eSpark-Backup/noise-alarm-v4.5-final/_Design Files v4.5/Audio_Meter_V4.5 - NEW.PcbDoc.htm

Reporting Options

# File in Newer Format

Date | : | 10/12/2020
Time | : | 4:24:38 PM
Filename | : | C:\Users\eSpark Group\Desktop\Final Core Files\Noise Alarm v4.5 - Final\_Design Files v4.5\Audio_Meter_V4.5 - NEW.PcbDoc

Version | Warning
Release 20.0 | CAUTION - Support of propagation delay for primitives

This file was generated by a later version of the software
