eSpark-Backup/noise-alarm-v4.5-final/_Deliverable/BOM/EDU BOM.xlsx

Bill of Material (BOM) for Eduardo_SMPS
S. No. | Comment Type | Description | Designator | Footprint (Package) | Manufacturer Part Number | Manufacturer | Value | Quantity | Total Quantity | Link | Unit Price | Total Price | Remarks
1 | Capacitor | CAP CER 0.1UF 50V Y5V 0805 | C1, C2, C3, C4, C7, C10, C12, C17, C19, C22, C24, C25, C76 | Cap0805 | CL21F104ZBCNNNC | Samsung | 0.1uF | 13 | 650 | Digikey (https://www.digikey.com/en/products/detail/samsung-electro-mechanics/CL21F104ZBCNNNC/3886665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) | $0.01 | $7.93
2 |  | CAP CER 1000PF 760VAC Y5U RADIAL | C5 | RAD-0.4 | 440LD10-R | Vishay | 1000pF | 1 | 50 | Mouser (https://eu.mouser.com/ProductDetail/Vishay-Cera-Mite/440LD10-R) | $0.49 | $24.50
3 |  | CAP CER 1UF 16V X7R 1206 | C8, C9 | Cap1206 | 1206YC105K4T2A | Kyocera AVX | 1uF | 2 | 100 | Digikey (https://www.digikey.com/en/products/detail/avx-corporation/1206YC105K4T2A/3081814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) | $0.15 | $14.85
4 |  | CAP CER 1UF 16V X7R 0805 | C11, C13, C16, C18, C78 | Cap0805 | CL21B105KOFNNNG | Samsung | 1uF | 5 | 250 | Digikey (https://www.digikey.com/en/products/detail/samsung-electro-mechanics/CL21B105KOFNNNG/3894469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) | $0.02 | $6.12
5 |  | CAP CER 4.7UF 16V 10% X5R 0805 | C26 | Cap0805 | C0805C475K4PACTU | KEMET | 4.7UF | 1 | 50 | Digikey (https://www.digikey.com/en/products/detail/kemet/C0805C475K4PACTU/2057920) | $0.11 | $5.47
6 |  | CAP CER 1000PF 200V X7R 0603 | CF1 | Cap0603 | 0603B102K201CT | Walsin Technologies | 1nF | 1 | 50 | Digikey (https://www.digikey.com/en/products/detail/walsin-technology-corporation/0603B102K201CT/9354876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) | $0.04 | $1.87
7 |  | CAP CER 0.33UF 50V X7R 0603 | CF3 | Cap0603 | CGA3E3X7R1H334M080AB | TDK | 0.33uF | 1 | 50 | Digikey (https://www.digikey.com/en/products/detail/tdk-corporation/CGA3E3X7R1H334M080AB/4931466) | $0.12 | $5.88
8 |  | CAP ALUM 560UF 20% 10V SMD | CF4, CF7 | EEE-TC1A561UV | EEE-TC1A561UV | Panasonic | 560uF | 2 | 100 | Digikey (https://www.digikey.com/en/products/detail/panasonic-electronic-components/EEE-TC1A561UV/10290506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) | $0.73 | $72.56
9 |  | CAP ALUM 4.7UF 20% 400V SMD | CF10, CF11 | ULR2G4R7MNL1GS | ULR2G4R7MNL1GS | Nichicon | 4.7uF | 2 | 100 | Digikey (https://www.digikey.com/en/products/detail/nichicon/ULR2G4R7MNL1GS/3664129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) | $0.39 | $39.03
10 | Diode | TVS DIODE 70.1V 113V DO214AA | D1 | SMB | SMBJP6KE82A-TP | MCC | SMBJP6KE82A-TP | 1 | 50 | Digikey (https://www.digikey.com/en/products/detail/micro-commercial-co/SMBJP6KE82A-TP/2345614) | $0.28 | $14.00
11 |  | DIODE GEN PURP 600V 1A SMB | D2 | SMB | MURS160-13 | Diodes | MURS160-13 | 1 | 50 | Digikey (https://www.digikey.com/en/products/detail/MURS160-13-F/MURS160-FDICT-ND/815906?curr=usd) | $0.28 | $14.10
12 |  | Diode Switching 100V 1A 2Pin SMA | D3 | SMA | RS1B-13-F | Diodes | RS1B-13-F | 1 | 50 | Digikey (https://www.digikey.com/en/products/detail/diodes-incorporated/RS1B-13-F/717796) | $0.28 | $14.15
13 |  | DIODE SCHOTTKY 30V 1A SOD123W | D4 | PMEG3010ER,115 | PMEG3010ER,115 | NXP Semiconductors | PMEG3010ER,115 | 1 | 50 | Digikey (https://www.digikey.com/en/products/detail/nexperia-usa-inc/PMEG3010ER115/2119868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) | $0.27 | $13.60
14 |  | DIODE SCHOTTKY 40V 3A SMB | DF1 | SMB | B340LB-13-F | Diodes | B340LB-13-F | 1 | 50 | Digikey (https://www.digikey.com/en/products/detail/diodes-incorporated/B340LB-13-F/755461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) | $0.32 | $15.90
15 |  | RECT BRIDGE GPP 1A 400V DFS | DF4 | DF04S-T | DF04S-T | Diodes | DF04S-T | 1 | 50 | Digikey (https://www.digikey.com/en/products/detail/diodes-incorporated/DF04S-T/1934941) | $0.37 | $18.45
16 | LED | ADDRESS LED DISC SERIAL RGB 1=10 | LED2 | 1655 | 1655 | Adafruit Industries | 1655 | 1 | 50 | Digikey (https://www.digikey.com/en/products/detail/adafruit-industries-llc/1655/5154679) | $4.50 | $225.00
17 | Inductor | Ind Power Wirewound 470uH 10% 140mA 1812 | L1 | 84474C | 84474C | Murata | 470uH | 1 | 50 | Digikey (https://www.digikey.com/en/products/detail/murata-power-solutions-inc/84474C/5798743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) | $0.37 | $18.70
18 | Mosfet | MOSFET P-CHAN 24V SOT23 | Q1 | SOT-23 | DMP2045U-7 | Diodes | DMP2045U-7 | 1 | 50 | Digikey (https://www.digikey.com/en/products/detail/diodes-incorporated/DMP2045U-7/8275356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) | $0.28 | $14.14
19 |  | TRANS NPN 40V 0.6A SMD SOT23-3 | Q2, Q3 | SOT-23 | MMBT2222A-7-F | Diodes | MMBT2222A-7-F | 2 | 100 | Digikey (https://www.digikey.com/en/products/detail/diodes-incorporated/MMBT2222A-7-F/814503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) | $0.05 | $5.00
20 |  | MOSFET N-CH 50V 200MA SOT-23 | Q4 | SOT-23 | BSS138LT1G | ON Semiconductor | BSS138LT1G | 1 | 50 | Digikey (https://www.digikey.com/en/products/detail/on-semiconductor/BSS138LT1G/918376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) | $0.17 | $8.60
21 |  | MOSFET N-CH 600V 2A DPAK | QS1 | STD2HNK60Z | STD2HNK60Z | STMicroelectronics | STD2HNK60Z | 1 | 50 | Digikey (https://www.digikey.com/en/products/detail/stmicroelectronics/STD2HNK60Z/1653989) | $0.83 | $41.72
22 | Resistor | RES SMD 1K OHM 5% 1/2W 0805 | R1, R6 | RES0805 | ERJ-P06J102V | Panasonic | 1K | 2 | 100 | Digikey (https://www.digikey.com/en/products/detail/panasonic-electronic-components/ERJ-P06J102V/525197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) | $0.04 | $3.60
23 |  | RES SMD 10K OHM 5% 1/2W 0805 | R2, R3, R4, R5, R8, R10, R12, R14, R24, R29, R39, R43, R56, R57, RC2, RC3 | RES0805 | ERJ-P06J103V | Panasonic | 10K | 16 | 800 | Digikey (https://www.digikey.com/en/products/detail/panasonic-electronic-components/ERJ-P06J103V/525198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) | $0.04 | $28.80
24 |  | RES SMD 47K OHM 1% 1/3W 0805 | R7 | RES0805 | CRCW080547K0FKEAHP | Vishay | 47K | 1 | 50 | Digikey (https://www.digikey.com/en/products/detail/vishay-dale/CRCW080547K0FKEAHP/2222360) | $0.19 | $9.65
25 |  | RES SMD 100K OHM 5% 1/2W 0805 | R9, R26 | RES0805 | ERJ-P06J104V | Panasonic | 100K | 2 | 100 | Digikey (https://www.digikey.com/en/products/detail/panasonic-electronic-components/ERJ-P06J104V/525199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) | $0.04 | $3.60
26 |  | RES SMD 220K OHM 5% 1/2W 0805 | R11 | RES0805 | ERJ-P06J224V | Panasonic | 220K | 1 | 50 | Digikey (https://www.digikey.com/en/products/detail/panasonic-electronic-components/ERJ-P06J224V/525240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) | $0.09 | $4.70
27 |  | RES SMD 470K OHM 1% 1/3W 0805 | R13 | RES0805 | CRCW0805470KFKEAHP | Vishay Dale | 470K | 1 | 50 | Digikey (https://www.digikey.com/en/products/detail/vishay-dale/CRCW0805470KFKEAHP/2227258) | $0.19 | $9.65
28 |  | RES SMD 665 OHM 1% 1/16W 0402 | R28 | Res0402 | RC0402FR-07665RL | Yageo | 665R | 1 | 50 | Digikey (https://www.digikey.com/en/products/detail/yageo/RC0402FR-07665RL/5281068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) | $0.01 | $0.70
29 |  | RES SMD 1M OHM 5% 1/2W 0805 | R32, R33 | RES0805 | ERJ-P06J105V | Panasonic | 1M | 2 | 100 | Digikey (https://www.digikey.com/en/products/detail/panasonic-electronic-components/ERJ-P06J105V/525200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) | $0.04 | $3.60
30 |  | RES SMD 10K OHM 5% 1/16W 0402, RES SMD 10K OHM 1% 1/10W 0402 | RC1, RF11, RF17 | Res0402 | RC0402JR-0710KL, ERJ-2RKF1002X | Yageo, Panasonic | 10K | 3 | 150 | Digikey (https://www.digikey.com/en/products/detail/yageo/RC0402JR-0710KL/726418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) | $0.10 | $15.00 | Review remaining
31 |  | RES 5.11M OHM 1% 1/4W 0805 | RF2, RF6, RF7 | RES 0805 | RK73H2ATTD5114F | KOA Speer | 5.11M | 3 | 150 | Digikey (https://www.digikey.com/en/products/detail/koa-speer-electronics-inc/RK73H2ATTD5114F/10234574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) | $0.01 | $1.86
32 |  | RES 487 OHM 1% 1/10W 0402 | RF8 | Res0402 | RK73H1ETTP4870F | KOA Speer | 487R | 1 | 50 | Digikey (https://www.digikey.com/en/products/detail/koa-speer-electronics-inc/RK73H1ETTP4870F/9844141) | $0.02 | $1.10
33 |  | RES 10 OHM 5% 1/10W 0402 | RF10 | Res0402 | RK73B1ETTP100J | KOA Speer | 10R | 1 | 50 | Digikey (https://www.digikey.com/en/products/detail/koa-speer-electronics-inc/RK73B1ETTP100J/9843968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) | $0.01 | $0.75
34 |  | RES SMD 10 OHM 5% 3W 2512 | RF12 | RES 2512 | 352210RJT | TE Connectivity CGS | 10R | 1 | 50 | Digikey (https://www.digikey.com/en/products/detail/te-connectivity-passive-product/352210RJT/5244975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) | $0.47 | $23.45
35 |  | RES 4.64K OHM 1% 1/10W 0402 | RF13 | Res-0402 | RK73H1ETTP4641F | KOA Speer | 4.64K | 1 | 50 | Digikey (https://www.digikey.com/en/products/detail/koa-speer-electronics-inc/RK73H1ETTP4641F/9844303) | $0.02 | $1.10 | Part changed. Need to change in design
36 |  | RES SMD 2.05 OHM 1% 1/10W 0603 | RF14 | Res0603 | CRCW06032R05FKEA | Vishay Dale | 2.05R | 1 | 50 | Digikey (https://www.digikey.com/en/products/detail/vishay-dale/CRCW06032R05FKEA/1961570) | $0.04 | $1.90 | Part changed. Need to change in design
37 |  | RES SMD 121K OHM 1% 1/10W 0402 | RF15 | Res0402 | ERJ-2RKF1213X | Panasonic | 121K | 1 | 50 | Digikey (https://www.digikey.com/en/products/detail/panasonic-electronic-components/ERJ-2RKF1213X/192111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) | $0.02 | $1.10
38 |  | RES 30.1K OHM 1% 1/10W 0402 | RF16 | Res0402 | RK73H1ETTP3012F | KOA Speer | 30.1K | 1 | 50 | Digikey (https://www.digikey.com/en/products/detail/koa-speer-electronics-inc/RK73H1ETTP3012F/9844092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) | $0.02 | $1.10
39 |  | RES SMD 22.6 OHM 1% 1/10W 0402 | RF18 | Res0402 | ERJ-2RKF22R6X | Panasonic | 22.6R | 1 | 50 | Digikey (https://www.digikey.com/en/products/detail/panasonic-electronic-components/ERJ-2RKF22R6X/79731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) | $0.02 | $1.10
40 |  | RES SMD 3.01K OHM 1% 1/10W 0402 | RF19 | Res-0402 | ERJ-2RKF3011X | Panasonic | 3.01K | 1 | 50 | Digikey (https://www.digikey.com/en/products/detail/panasonic-electronic-components/ERJ-2RKF3011X/192277) | $0.02 | $1.10 | Part changed. Need to change in design
41 | Switch | Tactile Switch SPST-NO Side Actuated Surface Mount, Right Angle | SW2 | KSS221GLFS | KSS221GLFS | ITT C&K | Switch | 1 | 50 | Digikey (https://www.digikey.com/product-detail/en/c-k/KSS221GLFS/401-1097-1-ND/417665) | $0.56 | $28.10
42 | Transformer | FLYBACK XFRM WE-FB T-WIN | TR1 | 750312723 | 750312723 | Wurth Electronics Midcom | 750312723 | 1 | 50 | Digikey (https://www.digikey.com/en/products/detail/w%C3%BCrth-elektronik/750311558/3992650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) | $5.75 | $287.45
43 | IC | SPU-TOP MIC IOT FOCUSED MIC | U1 | SPU0410HR5H-PB | SPU0410HR5H-PB | Knowles | SPU0410HR5H-PB | 1 | 50 | Digikey (https://www.digikey.com/product-detail/en/knowles/SPU0410HR5H-PB/423-1138-1-ND/2420982) | $0.70 | $35.19
44 |  | IC OPAMP GP 1 CIRCUIT SOT23-5 | U2, U3 | SOT23-5 | OPA344NA/250 | Texas Instruments | OPA344NA/250 | 2 | 100 | Digikey (https://www.digikey.com/product-detail/en/texas-instruments/OPA344NA-250/OPA344NACT-ND/362263) | $1.05 | $104.80
45 |  | IC SWITCH QUAD SPST 16TSSOP | U4 | 16-TSSOP | ADG712BRUZ-REEL | Analog Devices | ADG712BRUZ-REEL | 1 | 50 | Digikey (https://www.digikey.com/product-detail/en/analog-devices-inc/ADG712BRUZ-REEL/ADG712BRUZ-REELCT-ND/3771193) | $2.39 | $119.26
46 |  | WIFI MODULE 128MBITS SPI FLASH | U5 | ESP32-WROOM-32 (16MB) | ESP32-WROOM-32 (16MB) | Espressif Systems | ESP32-WROOM-32 (16MB) | 1 | 50 | Digikey (https://www.digikey.com/product-detail/en/espressif-systems/ESP32-WROOM-32D-16MB/1904-1025-1-ND/9381734) | $4.50 | $225.00
47 |  | IC REG LINEAR 3.3V 1A 8XDFN | U6 | NCP186AMX330TAG | NCP186AMX330TAG | ON Semiconductor | NCP186AMX330TAG | 1 | 50 | Digikey (https://www.digikey.com/product-detail/en/on-semiconductor/NCP186AMX330TAG/NCP186AMX330TAGOSCT-ND/5761671) | $0.35 | $17.30
48 |  | IC BAT CHG LI-ION 1 CELL SOT23-6 | U7 | SOT-23-6 | BQ21040DBVR | Texas Instruments | BQ21040DBVR | 1 | 50 | Digikey (https://www.digikey.com/product-detail/en/texas-instruments/BQ21040DBVR/296-47315-1-ND/7688325) | $1.01 | $50.40
49 |  | SENS HUMID/TEMP 3.6V I2C 2% 6DFN | U10 | SI7021-A20-GM1R | SI7021-A20-GM1R | Silicon Labs | SI7021-A20-GM1R | 1 | 50 | Digikey (https://www.digikey.com/en/products/detail/silicon-labs/SI7021-A20-GM1R/5048935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) | $3.24 | $162.18
50 |  | IC REG CTRLR FLYBK ISO SOT23-6 | IC2 | SOT-23-6 | UCC28700DBVR | Texas Instruments | UCC28700DBVR | 1 | 50 | Digikey (https://www.digikey.com/en/products/detail/texas-instruments/UCC28700DBVR/3588896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) | $0.98 | $49.00
51 | Connector | CABLE ADAPTER 6 POS | J1 | TC2030-IDC | TC2030-IDC | Tag-Connect | TC2030-IDC | 1 | 3 | Digikey (https://www.digikey.com/en/products/detail/tag-connect-llc/TC2030-IDC/4571121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) | $42.44 | $127.32
52 |  | CONN HEADER VERT 2POS 2.5MM | J5 | B2B-EH-A(LF)(SN) | B2B-EH-A(LF)(SN) | JST | B2B-EH-A(LF)(SN) | 1 | 50 | Digikey (https://www.digikey.com/products/en?keywords=B2B-EH-A(LF)(SN)) | $0.08 | $4.19
53 |  | TERMINAL BLOCK 2POS 5.08MM SIDE | J6, J7 | Terminal Block 2P | Terminal Block 2POS | TE Connectivity | Terminal Block 2POS | 2 | 100 | Digikey (https://www.digikey.com/product-detail/en/te-connectivity-amp-connectors/1776493-2/A122765-ND/2293915) | $0.49 | $48.62
54 |  | Test Point ON | P2, P4, P5, P6, P7, P8, P9, P18, P19, P20 | TEST POINT | TEST POINT |  | TEST POINT | 10 | 50 |  |  | $0.00 | DO NOT Mount
55 |  | Solder Bridge ON | SB1, SBxx | Solder Bridge | Solder Bridge |  | Solder Bridge | 2 | 10 |  |  | $0.00 | DO NOT Mount
 |  |  |  |  |  |  |  | Total Component Cost |  |  |  | $1954.25
 |  | Notes:
 |  | 1- The costing is done for Fifty (50) boards. All components will be calculated with multiplication factor Fifty (50).
 |  | 2- Supplier costing and custom charges are added in the final cost.
