eSpark-Backup/noise-alarm-v4.5-final/_Design Files v4.5/Audio_Meter_V4.5.step

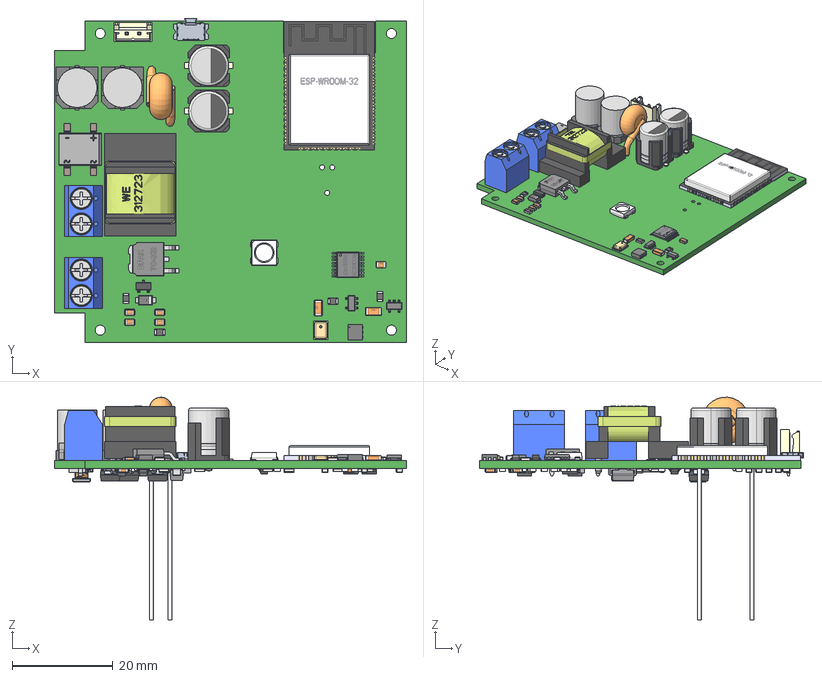
[picture p1: CAD file, 2020-10-13]
_Design Files v4.5/Audio_Meter_V4.5.step
70.0 x 64.5 x 44.3 mm
Board
Extruded
User_Library-RES_1005-0402 x 11
spu0410hr5h-pb
DFN6_3X3
440LD10-R
KSS221GLFS
User_Library-B2B-EH-A
User_Library-Terminal_block_2_POS_395443002 x 2
User_Library-Terminal_block_2_POS__155 x 2
User_Library-Terminal_block_2_POS__532 x 2
User_Library-Terminal_block_2_POS__752 x 2
User_Library-Terminal_block_2_POS_395443002_2 x 2
1655--3DModel-STEP-56544
User_Library-SOT23-6-2
User_Library-esp-wroom-32
User_Library-TSSOP-16-for-ON-SEMI-MC74HC595ADTR2G-Text
User_Library-SOT-23-5-1 x 2
RC2512N
User_Library-CR2012-0805 x 28
User_Library-DPAK_TO-252AA
CircuitWorks-SOT-23 x 4
core
coil
User_Library-SOT23-6-2_2725133846
User_Library-DFXXS
User_Library-SMBJ33CAHE3 x 3
User_Library-SOD123W
User_Library-DO-214AC_SMA
U2-P_NCH x 2
SIZE_CODE_F-001 x 2
SIZE_CODE_F-002 x 2
SIZE_CODE_F-003 x 4
SIZE_CODE_F-004 x 4
User_Library-CAPC1608X09 x 2
User_Library-0805_SMD_Capacitor x 19
User_Library-1206_SMD_Capacitor x 2
mid-olti-312723
