eSpark-Backup/noise-alarm-v4.5-final/_Design Files v4.5/mid-olti-312723.stp

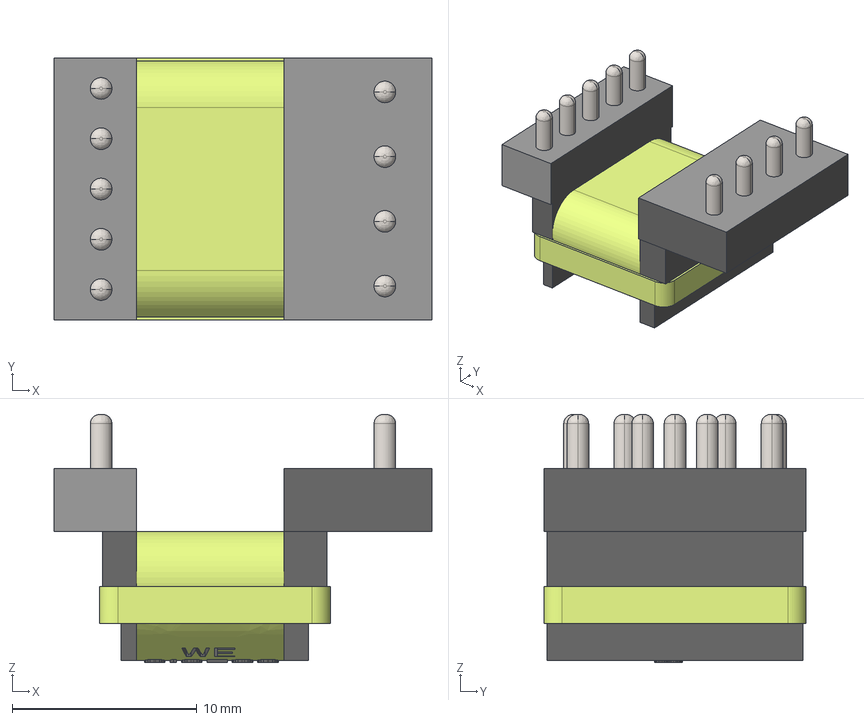
[picture p2: CAD file, 2020-10-13]
_Design Files v4.5/mid-olti-312723.stp
20.4 x 14.2 x 13.4 mm
