eSpark-Backup/noise-alarm-v4.5-final/(list of files, cad)

Other CAD files:
_Design Files v4.5/Audio_Meter_V4.5.DXF
