eSpark-Backup/noise-alarm-v4.5-final/_Design Files v4.5/Audio_Meter_V4.5.pdf

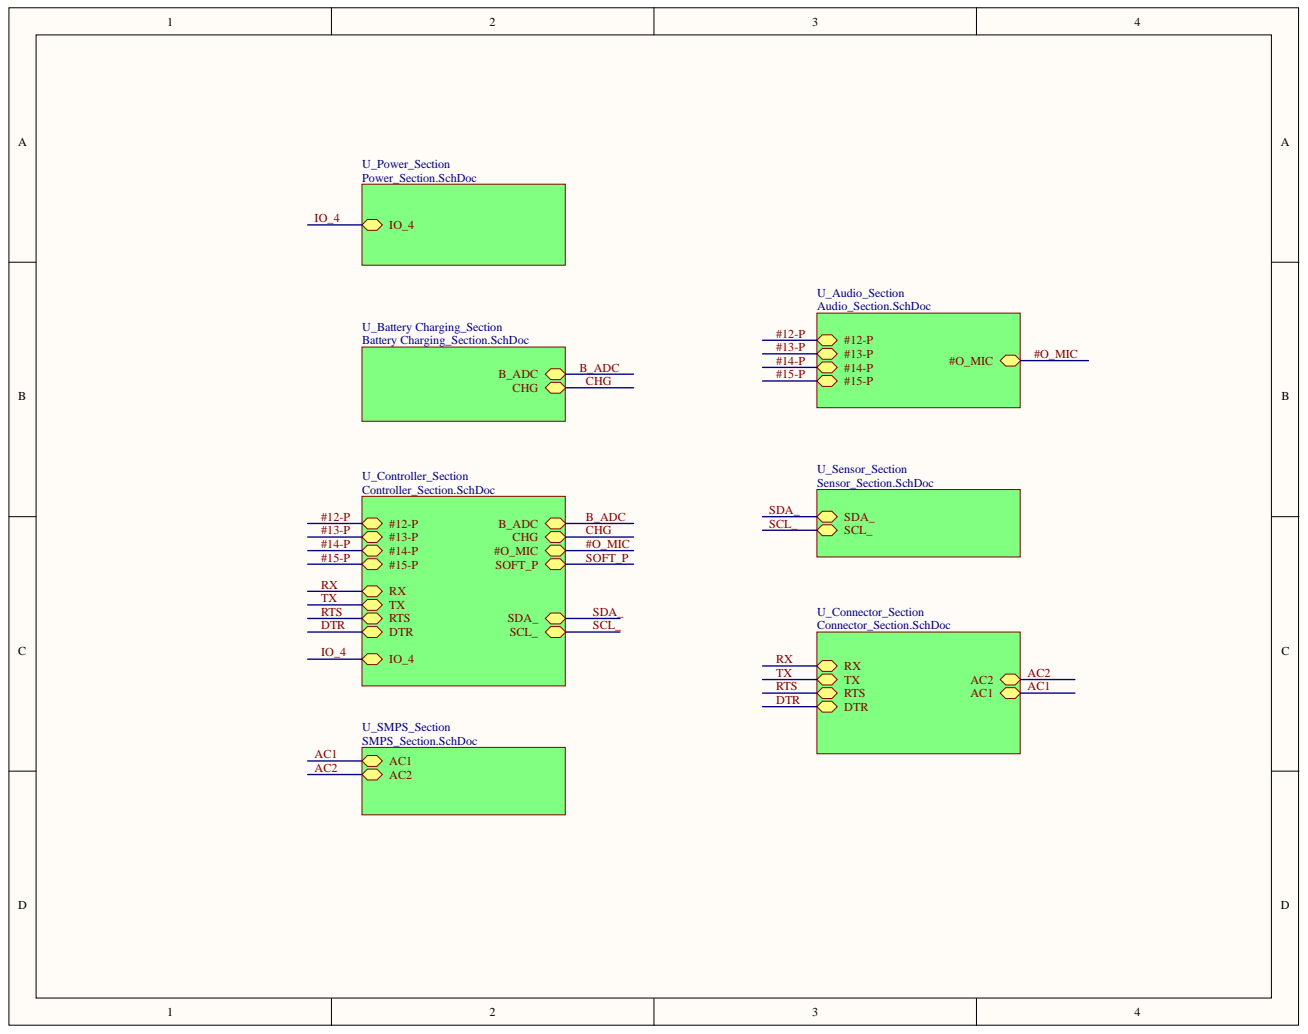
[picture p3: page 1]

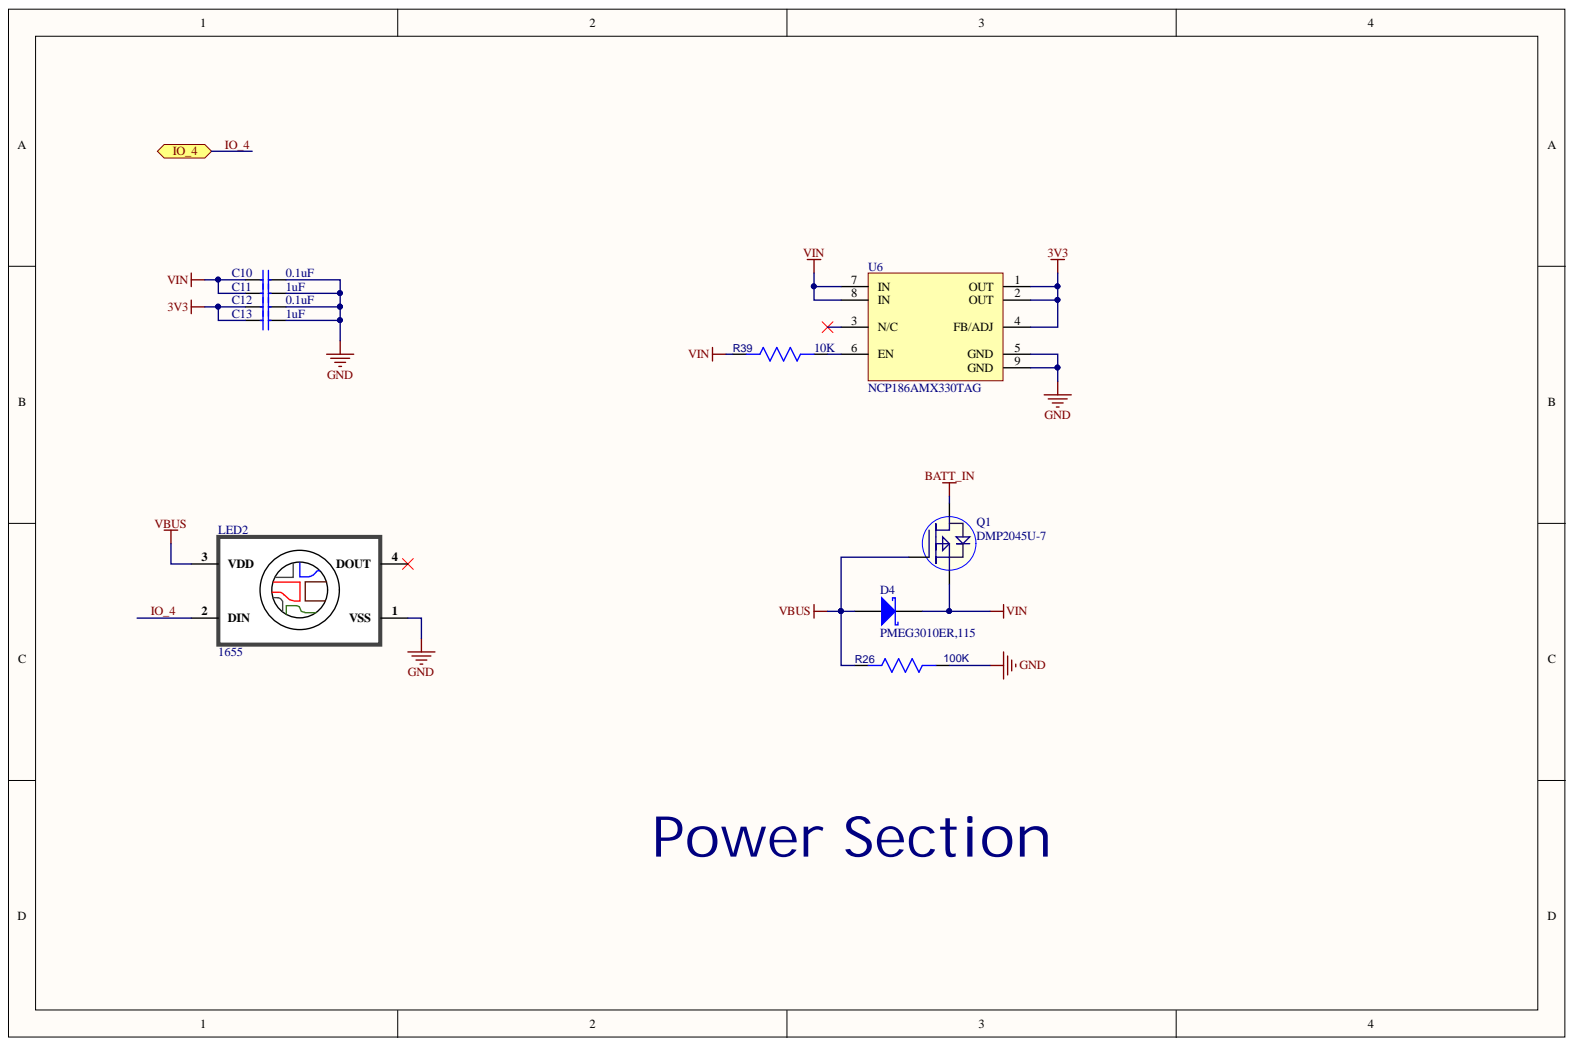
[picture p4: page 2]

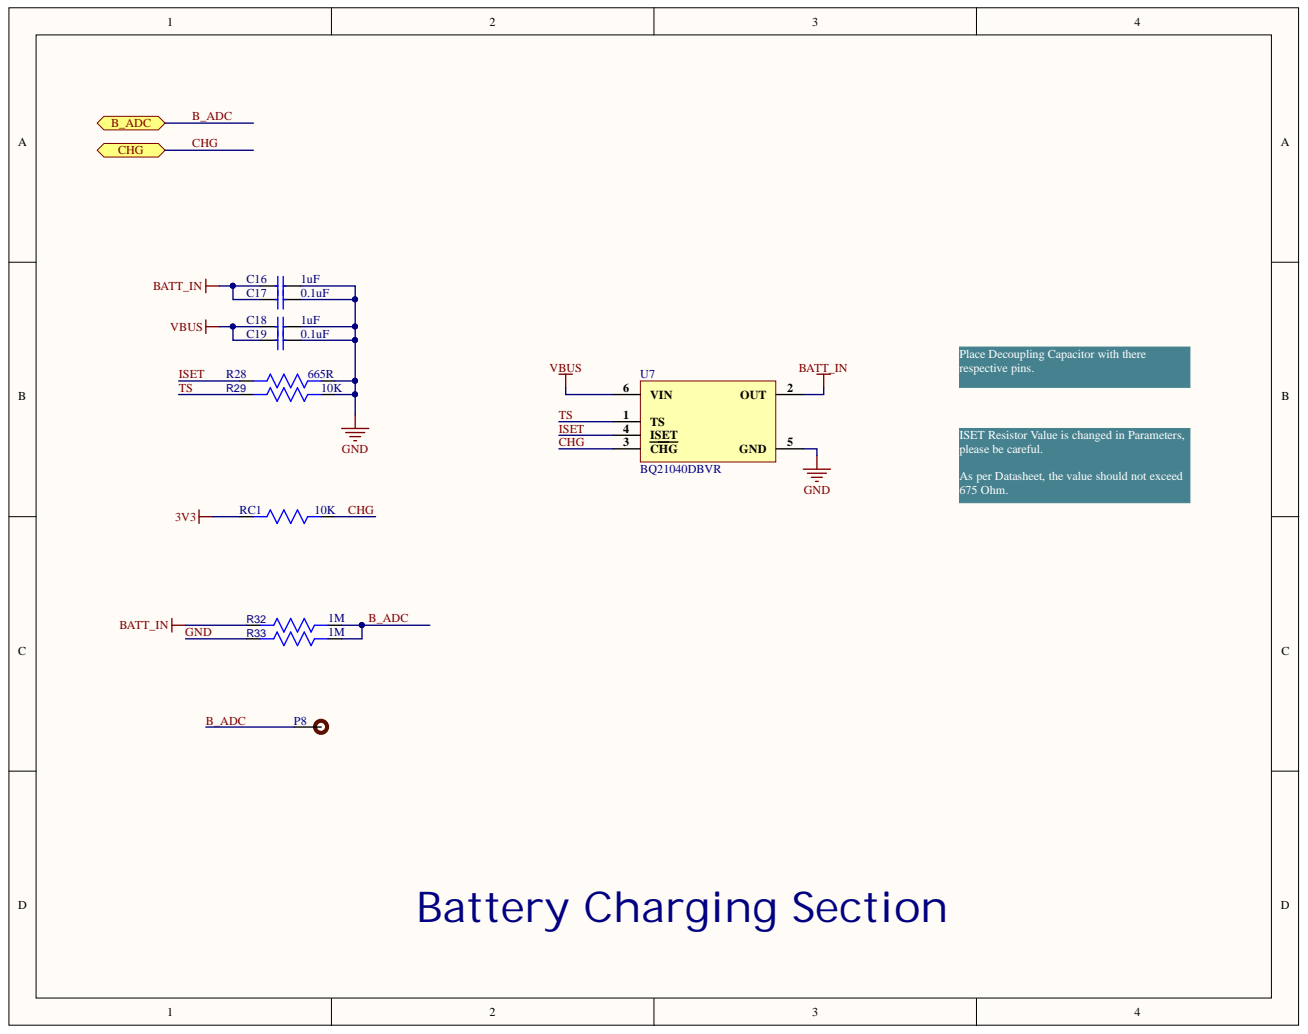
[picture p5: page 3]

Place Decoupling Capacitor with there
respective pins.

ISET Resistor Value is changed in Parameters,
please be careful.

As per Datasheet, the value should not exceed
675 Ohm.

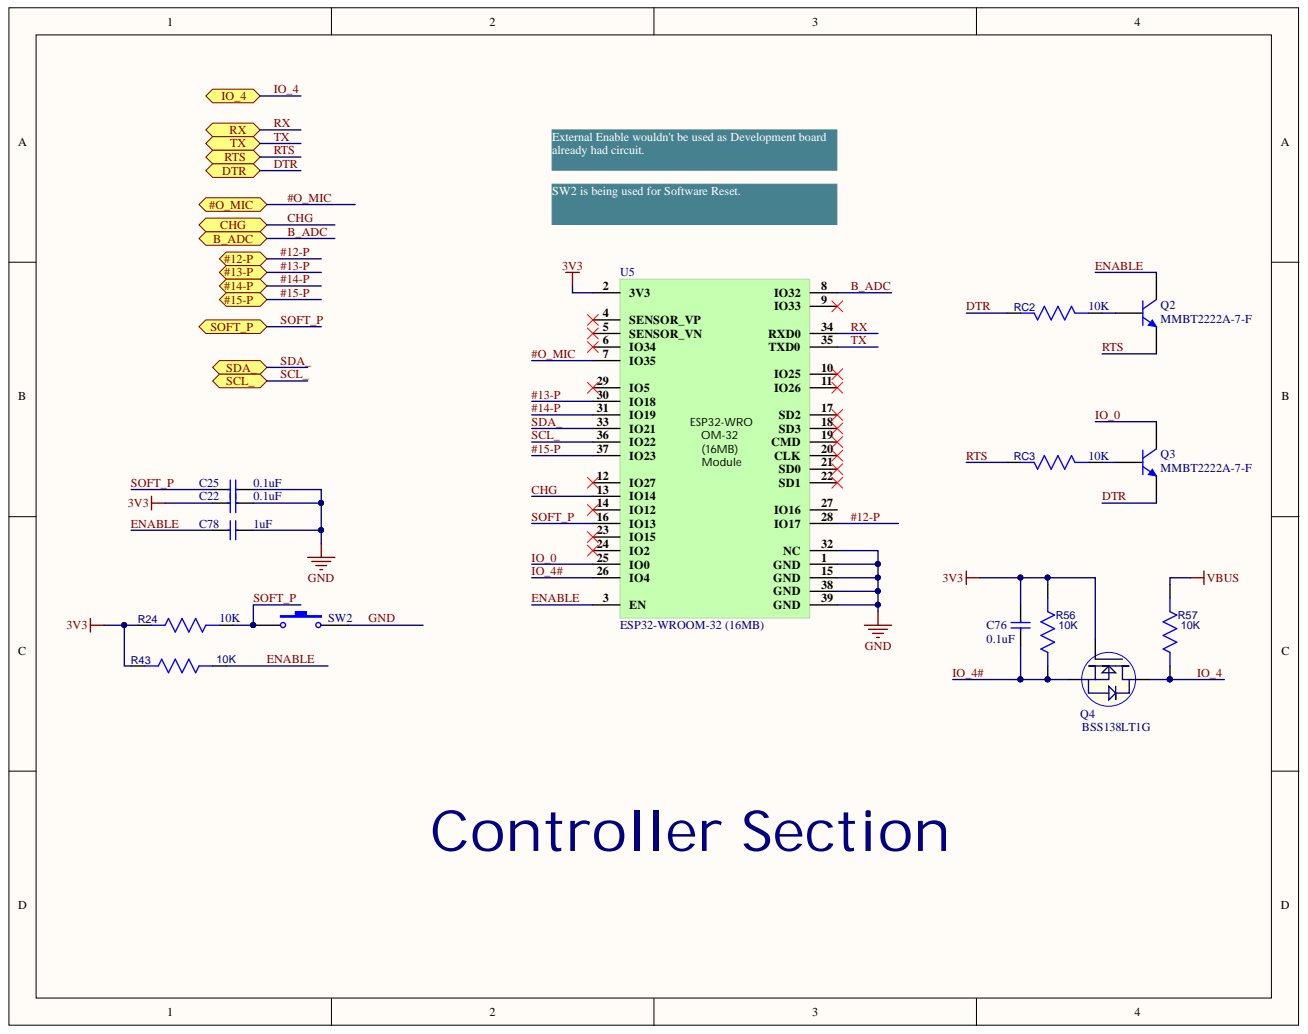
[picture p6: page 4]

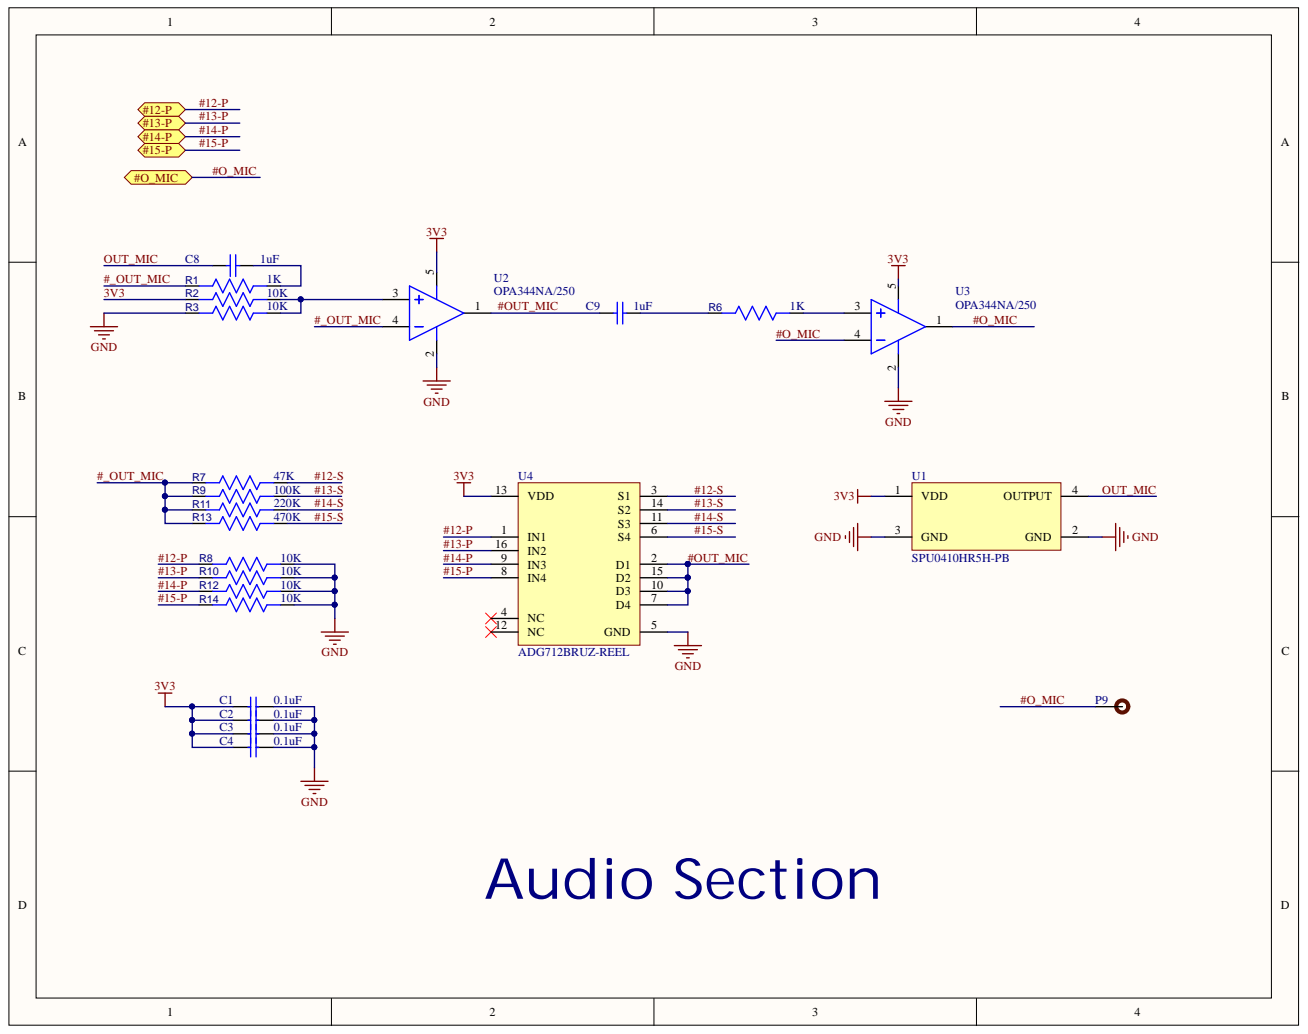
[picture p7: page 5]

C2 | | 0.1uF
C3 | | 0.1uF
C4 | 0.1uF

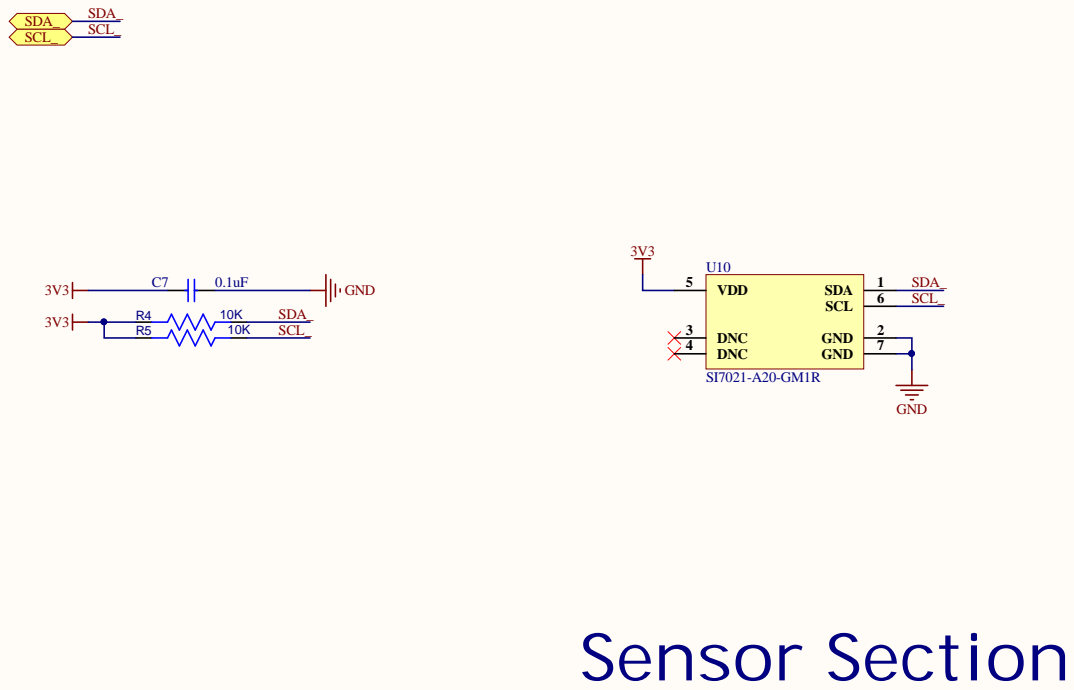
[picture p8: page 6]

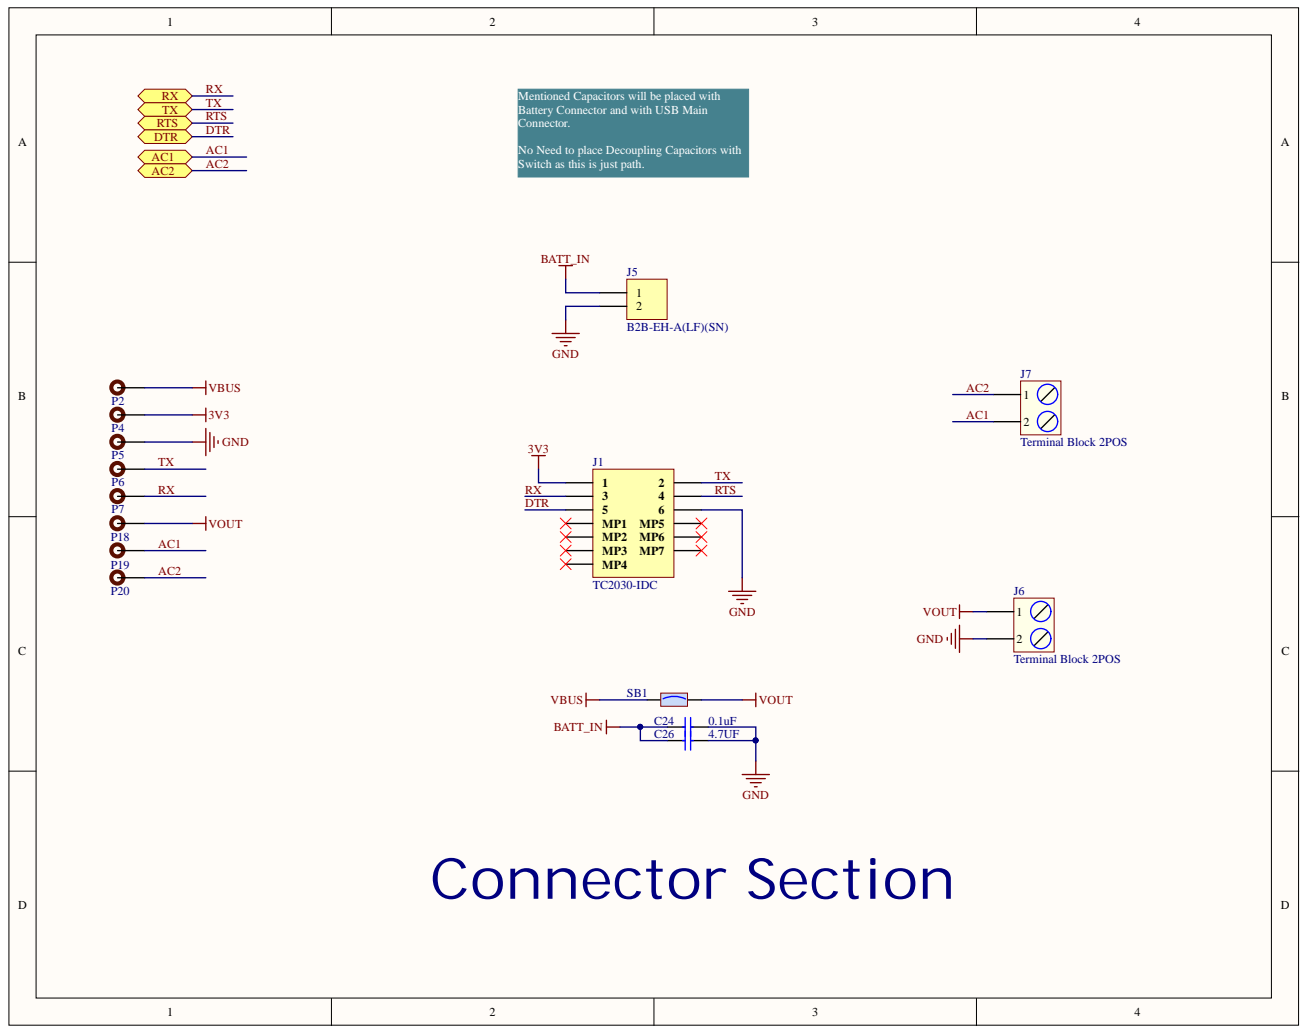
[picture p9: page 7]

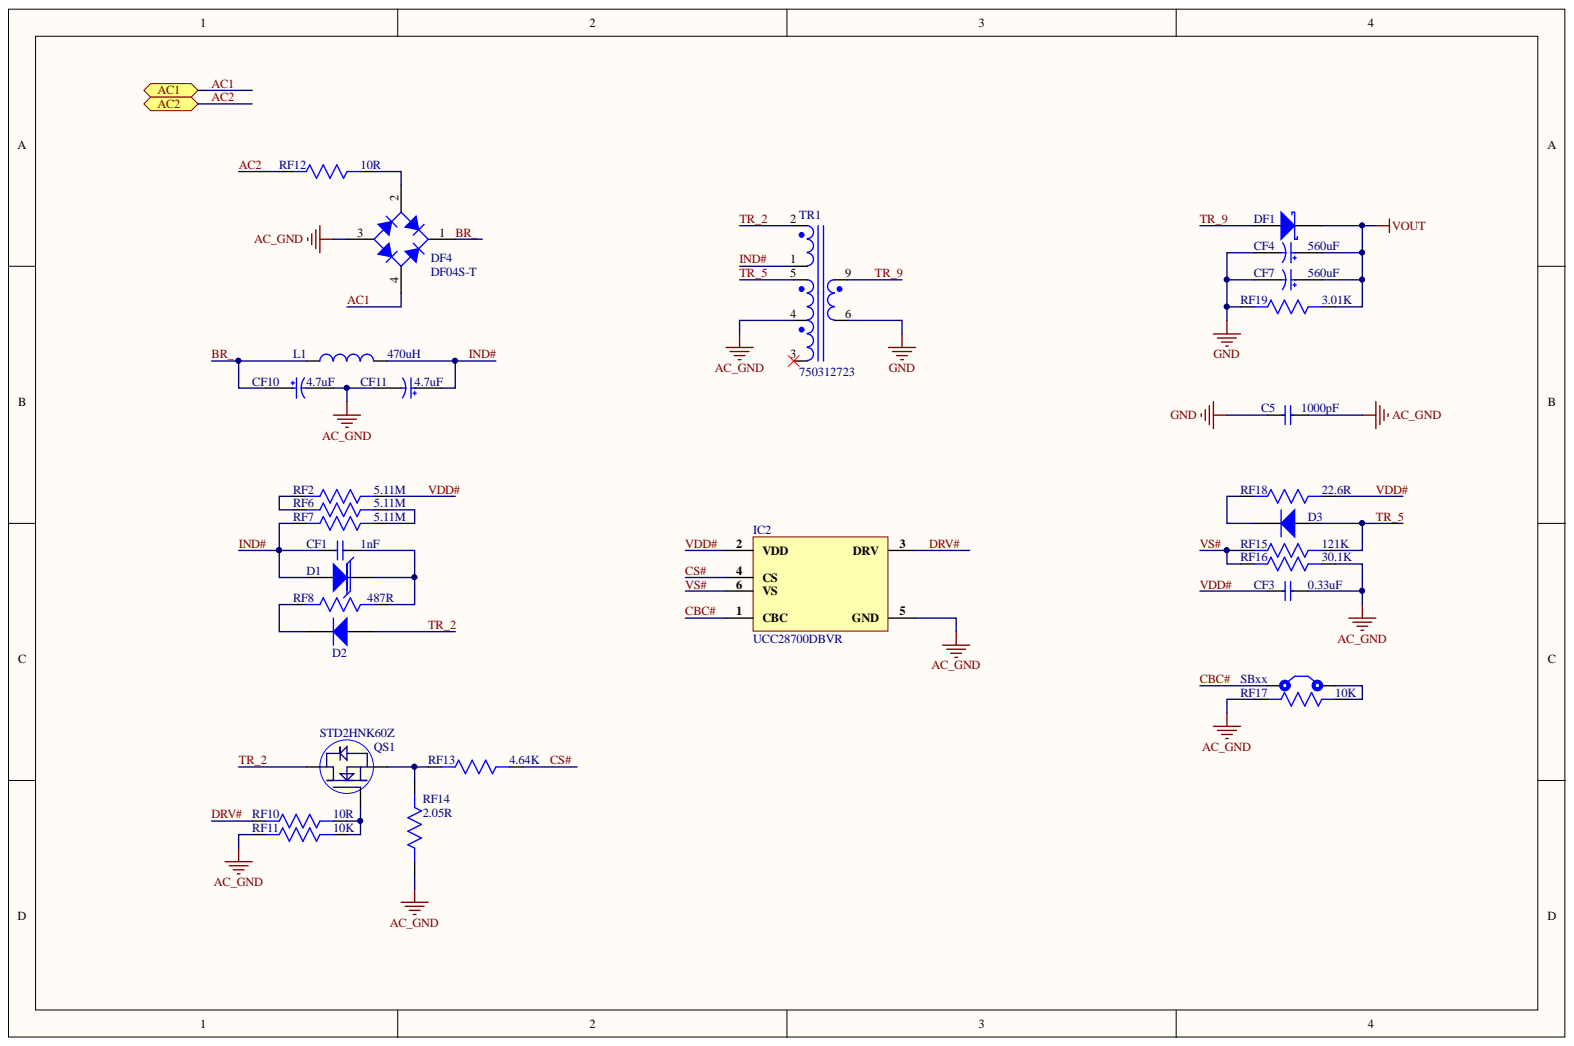
[picture p10: page 8]
