eSpark-Backup/noise-alarm-v4.5-final/(list of files, drawings)

Other design files:
_Design Files v4.5/Audio_Meter_V4.5.PcbDoc
_Design Files v4.5/Audio_Meter_V4.5.PrjPcb
_Design Files v4.5/Audio_Section.SchDoc
_Design Files v4.5/Battery Charging_Section.SchDoc
_Design Files v4.5/Connector_Section.SchDoc
_Design Files v4.5/Controller_Section.SchDoc
_Design Files v4.5/Power_Section.SchDoc
_Design Files v4.5/Power_Section_SMPS.SchDoc
_Design Files v4.5/Sensor_Section.SchDoc
_Design Files v4.5/SMPS_Section.SchDoc
_Design Files v4.5/Top_Sheet.SchDoc
