eSpark-Backup/noise-alarm-v4.5-final/(commit log)

2020-09-05 Add Audio_Meter_V3.2.PcbDoc.htm
2020-10-07 Add Power_Section_SMPS.SchDoc
    [Power_Section_SMPS.SchDoc]
2020-10-07 Add Power_Section_SMPS.SchDocPreview
2020-10-12 Add Audio_Meter_V4.5.PcbDoc.htm
2020-10-12 Add Audio_Section.SchDoc
    [Audio_Section.SchDoc]
2020-10-12 Add Battery Charging_Section.SchDoc
    [Battery Charging_Section.SchDoc]
2020-10-12 Add Connector_Section.SchDoc
    [Connector_Section.SchDoc]
2020-10-12 Add Power_Section.SchDoc
    [Power_Section.SchDoc]
2020-10-12 Add Sensor_Section.SchDoc
    [Sensor_Section.SchDoc]
2020-10-12 Add Top_Sheet.SchDoc
    [Top_Sheet.SchDoc]
2020-10-12 Add SMPS_Section.SchDoc
    [SMPS_Section.SchDoc]
2020-10-12 Add Audio_Meter_V4.5 - NEW.PcbDoc.htm
2020-10-13 Add Controller_Section.SchDoc
    [Controller_Section.SchDoc]
2020-10-13 Add Audio_Meter_V4.5 (Schematic).pdf
2020-10-13 Add Battery Charging_Section.SchDocPreview
2020-10-13 Add Connector_Section.SchDocPreview
2020-10-13 Add Power_Section.SchDocPreview
2020-10-13 Add Sensor_Section.SchDocPreview
2020-10-13 Add Audio_Meter_V4.5.DXF
    [Audio_Meter_V4.5.DXF]
2020-10-13 Add Assembly Drawings.pdf
2020-10-13 Add EDU BOM.xlsx
    [EDU BOM.xlsx]
2020-10-13 Add mid-olti-312723.stp
    [mid-olti-312723.stp]
2020-10-13 Add Audio_Meter_V4.5.step
    [Audio_Meter_V4.5.step]
2020-10-13 Add Audio_Meter_V4.5.PcbDoc
    [Audio_Meter_V4.5.PcbDoc]
2020-10-13 Add Pick Place for Audio_Meter_V4.5.csv
    [Pick Place for Audio_Meter_V4.5.csv]
2020-10-13 Add Audio_Meter_V4.5.GTO
    [Audio_Meter_V4.5.GTO]
2020-10-13 Add Audio_Meter_V4.5.GTP
    [Audio_Meter_V4.5.GTP]
2020-10-13 Add Audio_Meter_V4.5.GTS
    [Audio_Meter_V4.5.GTS]
2020-10-13 Add Audio_Meter_V4.5.GTL
    [Audio_Meter_V4.5.GTL]
2020-10-13 Add Audio_Meter_V4.5.GBL
    [Audio_Meter_V4.5.GBL]
2020-10-13 Add Audio_Meter_V4.5.GBS
    [Audio_Meter_V4.5.GBS]
2020-10-13 Add Audio_Meter_V4.5.GBP
    [Audio_Meter_V4.5.GBP]
2020-10-13 Add Audio_Meter_V4.5.GBO
    [Audio_Meter_V4.5.GBO]
2020-10-13 Add Gerber Files.Cam
2020-10-13 Add NC Drill Files.Cam
2020-10-13 Add Audio_Meter_V4.5.PrjPcb
    [Audio_Meter_V4.5.PrjPcb]
